Sehwani2/haptic-macropad/hw/PCB.jpeg

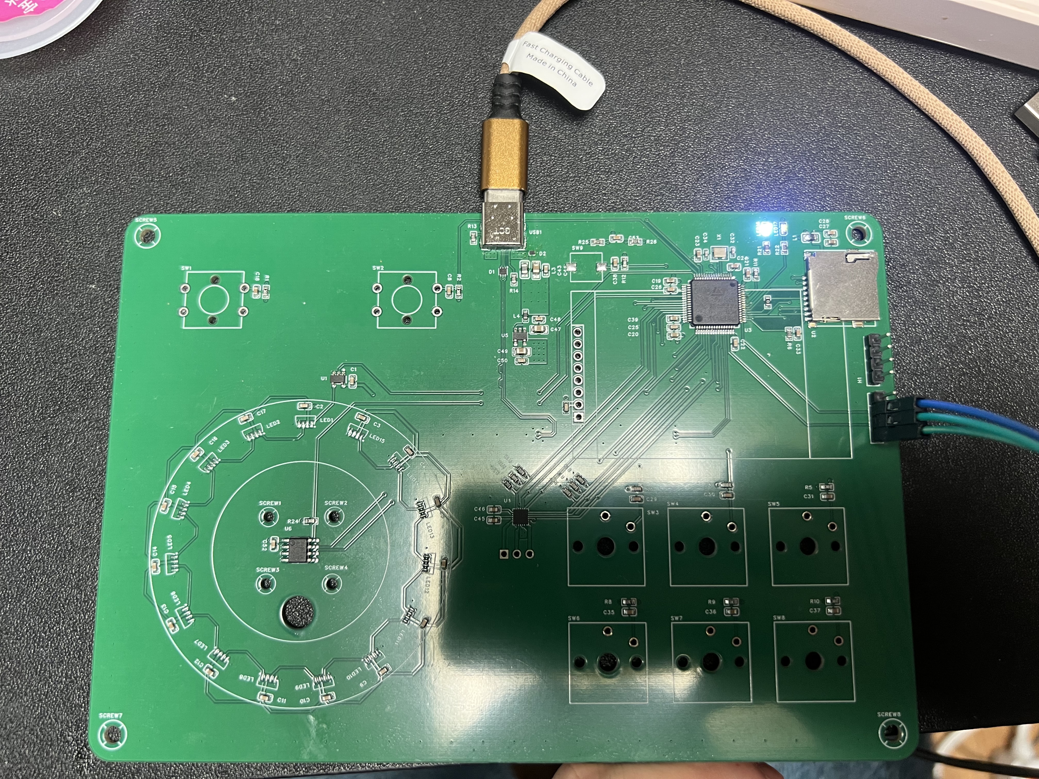
hw/PCB.jpeg
