Sehwani2/haptic-macropad/hw/layout.png

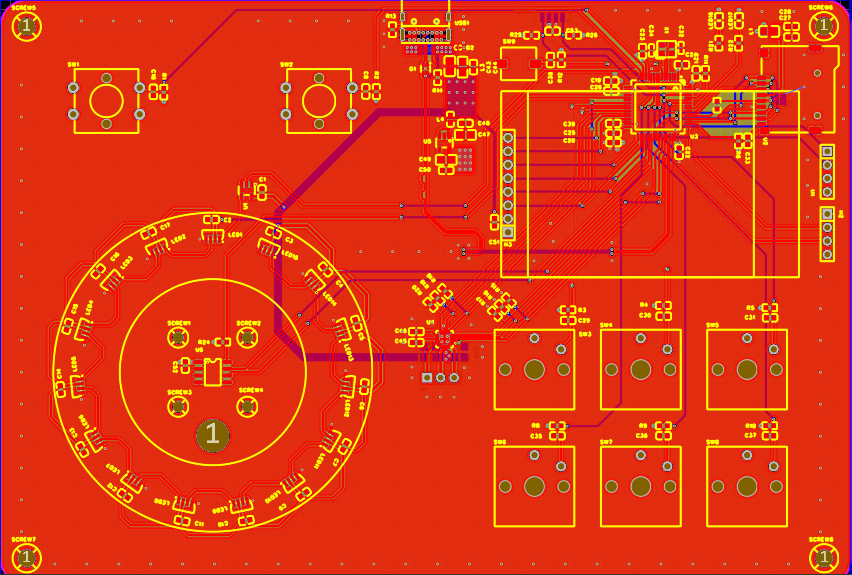
hw/layout.png
