Sehwani2/haptic-macropad/hw/schematic.png

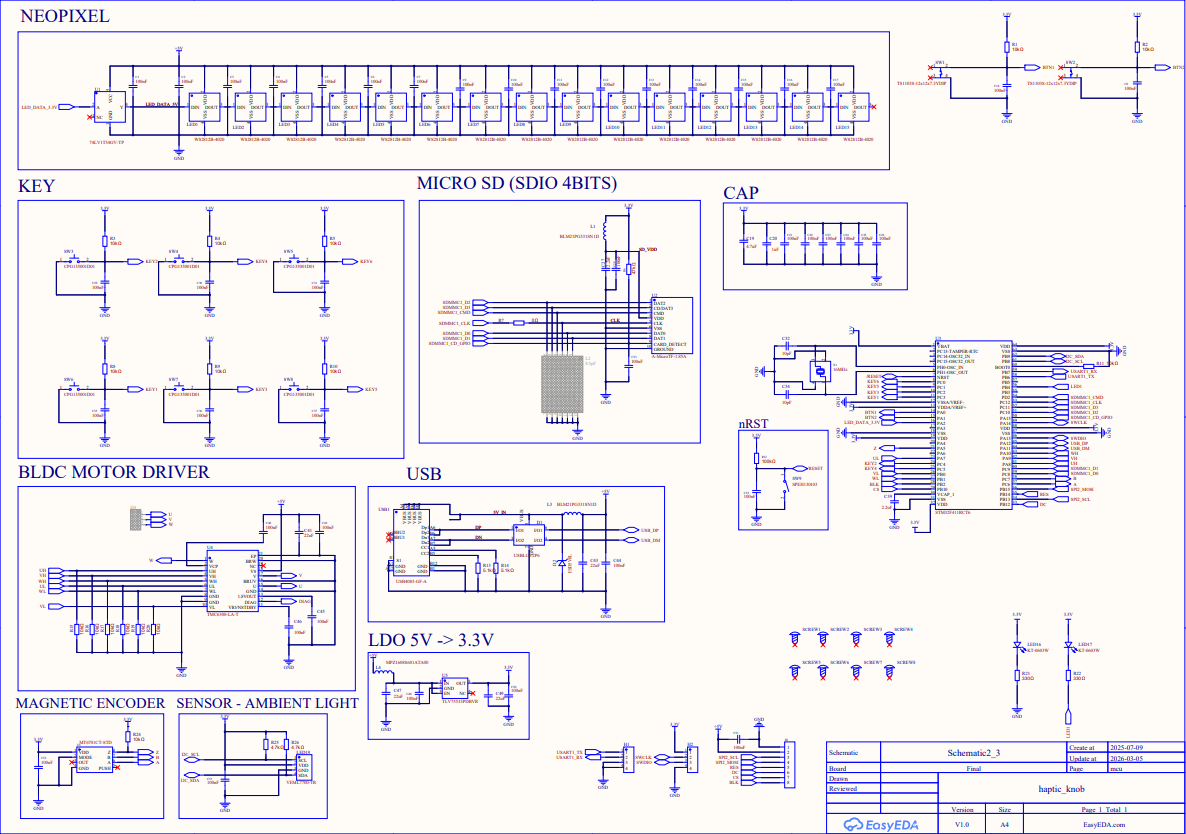
hw/schematic.png
