Sehwani2/haptic-macropad/(list of files, drawings)

Other design files:
hw/haptic_knob.eprj
