Sehwani2/haptic-macropad/fw/bldc_knob_key/bldc_knob_key.ioc

Mcu.UserName=STM32F411RCTx
PA0-WKUP.GPIO_Label=BTN1
PA0-WKUP.Signal=GPIO_Input
PA1.GPIO_Label=BTN2
PA1.Signal=GPIO_Input
PA10.Signal=S_TIM1_CH3
PA11.Signal=USB_OTG_FS_DM
PA12.Signal=USB_OTG_FS_DP
PA13.Signal=SYS_JTMS-SWDIO
PA14.Signal=SYS_JTCK-SWCLK
PA15.GPIO_Label=SDMMC1_CD_GPIO
PA15.Signal=GPIO_Input
PA2.Signal=S_TIM2_CH3
PA5.GPIO_Label=Z
PA5.Signal=GPXTI5
PA7.Signal=TIM1_CH1N
PA8.Signal=S_TIM1_CH1
PA9.Signal=S_TIM1_CH2
PB0.Signal=TIM1_CH2N
PB1.Signal=TIM1_CH3N
PB10.GPIO_Label=LCD_CS
PB10.Signal=GPIO_Output
PB12.GPIO_Label=LCD_DC
PB12.Signal=GPIO_Output
PB13.Signal=SPI2_SCK
PB14.GPIO_Label=LCD_RES
PB14.Signal=GPIO_Output
PB15.Signal=SPI2_MOSI
PB2.GPIO_Label=LCD_BLK
PB2.Signal=GPIO_Output
PB4.GPIO_Label=LED1
PB4.Signal=GPIO_Output
PB6.Signal=USART1_TX
PB7.Signal=USART1_RX
PB8.Signal=I2C1_SCL
PB9.Signal=I2C1_SDA
PC0.GPIO_Label=KEY3
PC0.Signal=GPIO_Input
PC1.GPIO_Label=KEY6
PC1.Signal=GPIO_Input
PC10.Signal=SDIO_D2
PC11.Signal=SDIO_D3
PC12.Signal=SDIO_CK
PC2.GPIO_Label=KEY5
PC2.Signal=GPIO_Input
PC3.GPIO_Label=KEY4
PC3.Signal=GPIO_Input
PC4.GPIO_Label=KEY1
PC4.Signal=GPIO_Input
PC5.GPIO_Label=KEY2
PC5.Signal=GPIO_Input
PC6.Signal=S_TIM3_CH1
PC7.Signal=S_TIM3_CH2
PC8.Signal=SDIO_D0
PC9.Signal=SDIO_D1
PD2.Signal=SDIO_CMD
