Sehwani2/haptic-macropad/fw/bldc_knob_key/Core/Inc/main.h

#define KEY3_Pin GPIO_PIN_0
#define KEY3_GPIO_Port GPIOC
#define KEY6_Pin GPIO_PIN_1
#define KEY6_GPIO_Port GPIOC
#define KEY5_Pin GPIO_PIN_2
#define KEY5_GPIO_Port GPIOC
#define KEY4_Pin GPIO_PIN_3
#define KEY4_GPIO_Port GPIOC
#define BTN1_Pin GPIO_PIN_0
#define BTN1_GPIO_Port GPIOA
#define BTN2_Pin GPIO_PIN_1
#define BTN2_GPIO_Port GPIOA
#define Z_Pin GPIO_PIN_5
#define Z_GPIO_Port GPIOA
#define Z_EXTI_IRQn EXTI9_5_IRQn
#define KEY1_Pin GPIO_PIN_4
#define KEY1_GPIO_Port GPIOC
#define KEY2_Pin GPIO_PIN_5
#define KEY2_GPIO_Port GPIOC
#define LCD_BLK_Pin GPIO_PIN_2
#define LCD_BLK_GPIO_Port GPIOB
#define LCD_CS_Pin GPIO_PIN_10
#define LCD_CS_GPIO_Port GPIOB
#define LCD_DC_Pin GPIO_PIN_12
#define LCD_DC_GPIO_Port GPIOB
#define LCD_RES_Pin GPIO_PIN_14
#define LCD_RES_GPIO_Port GPIOB
#define SDMMC1_CD_GPIO_Pin GPIO_PIN_15
#define SDMMC1_CD_GPIO_GPIO_Port GPIOA
#define LED1_Pin GPIO_PIN_4
#define LED1_GPIO_Port GPIOB
