Sehwani2/haptic-macropad/fw/bldc_knob_key/App/hw/src/st7789.c

#include "st7789.h"
#include "st7789_regs.h"
#include "gpio.h"
#include "cli.h"
#include "stm32f4xx_ll_spi.h"

#ifdef _USE_HW_ST7789

#define _PIN_DEF_BL     0
#define _PIN_DEF_DC     2
#define _PIN_DEF_CS     3
#define _PIN_DEF_RST    1


#define MADCTL_MY       0x80
#define MADCTL_MX       0x40
#define MADCTL_MV       0x20
#define MADCTL_ML       0x10
#define MADCTL_RGB      0x00
#define MADCTL_BGR      0x08
#define MADCTL_MH       0x04

#define FRAME_BUF_CNT   5


static void writecommand(uint8_t c);
static void writedata(uint8_t d);
static void st7789InitRegs(void);
static void st7789SetRotation(uint8_t m);
static bool st7789Reset(void);
static void st7789DoneISR(SPI_HandleTypeDef *hspi);


extern SPI_HandleTypeDef hspi2;

static volatile bool is_ready = true;

static bool is_init = false;
static uint32_t pre_time_req;
static uint32_t exe_time_req;

static const int32_t _width  = HW_ST7789_WIDTH;
static const int32_t _height = HW_ST7789_HEIGHT;
static const uint32_t colstart = 1;
static const uint32_t rowstart = 2;



#ifdef _USE_HW_CLI
static void cliCmd(cli_args_t *args);
#endif





bool st7789Init(void)
{
  bool ret = true;

  if (is_init)
    return true;

  ret = st7789Reset();

  is_init = ret;

  HAL_SPI_RegisterCallback(&hspi2, HAL_SPI_TX_COMPLETE_CB_ID, st7789DoneISR);

#ifdef _USE_HW_CLI
  cliAdd("st7789", cliCmd);
#endif

  return ret;
}

void st7789DoneISR(SPI_HandleTypeDef *hspi)
{
  gpioPinWrite(_PIN_DEF_CS, _DEF_HIGH);

  hspi2.Init.DataSize = SPI_DATASIZE_8BIT;
  LL_SPI_SetDataWidth(hspi2.Instance, LL_SPI_DATAWIDTH_8BIT);

  exe_time_req = millis()-pre_time_req;
  is_ready = true;
}

bool st7789IsReady(void)
{
  return is_ready;
}

void st7789GetInfo(st7789_info_t *p_info)
{
  p_info->req_time = exe_time_req;
}

bool st7789Reset(void)
{
  gpioPinWrite(_PIN_DEF_BL , _DEF_LOW);
  gpioPinWrite(_PIN_DEF_DC , _DEF_HIGH);
  gpioPinWrite(_PIN_DEF_CS , _DEF_HIGH);
  gpioPinWrite(_PIN_DEF_RST, _DEF_LOW);
  delay(10);
  gpioPinWrite(_PIN_DEF_RST, _DEF_HIGH);

  st7789InitRegs();

  st7789SetRotation(1);
  st7789FillRect(0, 0, _width, _height, black);
  return true;
}

uint16_t st7789GetWidth(void)
{
  return _width;
}

uint16_t st7789GetHeight(void)
{
  return _height;
}

void writecommand(uint8_t c)
{
  gpioPinWrite(_PIN_DEF_DC, _DEF_LOW);
  gpioPinWrite(_PIN_DEF_CS, _DEF_LOW);

  HAL_SPI_Transmit(&hspi2, &c, 1, 50);

  gpioPinWrite(_PIN_DEF_CS, _DEF_HIGH);
}

void writedata(uint8_t d)
{
  gpioPinWrite(_PIN_DEF_DC, _DEF_HIGH);
  gpioPinWrite(_PIN_DEF_CS, _DEF_LOW);

  HAL_SPI_Transmit(&hspi2, &d, 1, 50);

  gpioPinWrite(_PIN_DEF_CS, _DEF_HIGH);
}

void st7789InitRegs(void)
{
  writecommand(ST7789_SWRESET); //  1: Software reset, 0 args, w/delay
  delay(10);

  writecommand(ST7789_SLPOUT);  //  2: Out of sleep mode, 0 args, w/delay
  delay(10);

 // writecommand(ST7789_INVON);  // 13: Don't invert display, no args, no delay
  writecommand(ST7789_INVOFF);

  writecommand(ST7789_MADCTL);  // 14: Memory access control (directions), 1 arg:
  writedata(0x08);              //     row addr/col addr, bottom to top refresh

  writecommand(ST7789_COLMOD);  // 15: set color mode, 1 arg, no delay:
  writedata(0x05);              //     16-bit color


  writecommand(ST7789_CASET);   //  1: Column addr set, 4 args, no delay:
  writedata(0x00);
  writedata(0x00);              //     XSTART = 0
  writedata((uint8_t)((HW_ST7789_WIDTH-1)>>8));
  writedata((uint8_t)((HW_ST7789_WIDTH-1)>>0));    //     XEND =

  writecommand(ST7789_RASET);   //  2: Row addr set, 4 args, no delay:
  writedata(0x00);
  writedata(0x00);              //     XSTART = 0
  writedata((uint8_t)((HW_ST7789_HEIGHT-1)>>8));
  writedata((uint8_t)((HW_ST7789_HEIGHT-1)>>0));   //     XEND =


  writecommand(ST7789_NORON);   //  3: Normal display on, no args, w/delay
  delay(10);
  writecommand(ST7789_DISPON);  //  4: Main screen turn on, no args w/delay
  delay(10);
}

void st7789SetRotation(uint8_t mode)
{
  writecommand(ST7789_MADCTL);

  switch (mode)
  {
   case 0:
     writedata(MADCTL_MX | MADCTL_MY | MADCTL_RGB);
     break;

   case 1:
     writedata(MADCTL_MY | MADCTL_MV | MADCTL_RGB);
     break;

  case 2:
    writedata(MADCTL_RGB);
    break;

   case 3:
     writedata(MADCTL_MX | MADCTL_MV | MADCTL_RGB);
     break;
  }
}

void st7789SetWindow(int32_t x0, int32_t y0, int32_t x1, int32_t y1)
{
  writecommand(ST7789_CASET);   // Column addr set
  writedata((x0+colstart)>>8);
  writedata((x0+colstart)>>0);  // XSTART
  writedata((x1+colstart)>>8);
  writedata((x1+colstart)>>0);  // XEND

  writecommand(ST7789_RASET);   // Row addr set
  writedata((y0+rowstart)>>8);
  writedata((y0+rowstart)>>0);  // YSTART
  writedata((y1+rowstart)>>8);
  writedata((y1+rowstart)>>0);  // YEND

  writecommand(ST7789_RAMWR);   // write to RAM
}

void st7789FillRect(int32_t x, int32_t y, int32_t w, int32_t h, uint32_t color)
{
  uint16_t line_buf[w];

  // Clipping
  if ((x >= _width) || (y >= _height)) return;

  if (x < 0) { w += x; x = 0; }
  if (y < 0) { h += y; y = 0; }

  if ((x + w) > _width)  w = _width  - x;
  if ((y + h) > _height) h = _height - y;

  if ((w < 1) || (h < 1)) return;


  st7789SetWindow(x, y, x + w - 1, y + h - 1);

  hspi2.Init.DataSize = SPI_DATASIZE_16BIT;
  LL_SPI_SetDataWidth(hspi2.Instance, LL_SPI_DATAWIDTH_16BIT);

  gpioPinWrite(_PIN_DEF_DC, _DEF_HIGH);
  gpioPinWrite(_PIN_DEF_CS, _DEF_LOW);

  for (int i=0; i<w; i++)
  {
    line_buf[i] = color;
  }
  for (int i=0; i<h; i++)
  {
    HAL_SPI_Transmit(&hspi2, (const uint8_t *)line_buf, w, 10);
  }
  gpioPinWrite(_PIN_DEF_CS, _DEF_HIGH);

  hspi2.Init.DataSize = SPI_DATASIZE_8BIT;
  LL_SPI_SetDataWidth(hspi2.Instance, LL_SPI_DATAWIDTH_8BIT);
}

bool st7789SendBuffer(uint8_t *p_data, uint32_t length, uint32_t timeout_ms)
{
  is_ready = false;
  pre_time_req = millis();

  hspi2.Init.DataSize = SPI_DATASIZE_16BIT;
  LL_SPI_SetDataWidth(hspi2.Instance, LL_SPI_DATAWIDTH_16BIT);

  gpioPinWrite(_PIN_DEF_DC, _DEF_HIGH);
  gpioPinWrite(_PIN_DEF_CS, _DEF_LOW);


  HAL_SPI_Transmit_DMA(&hspi2, (const uint8_t *)p_data, length);

  return true;
}



#ifdef _USE_HW_CLI

void cliCmd(cli_args_t *args)
{
  bool ret = false;


  if (args->argc == 1 && args->isStr(0, "info"))
  {
    cliPrintf("Width  : %d\n", _width);
    cliPrintf("Heigth : %d\n", _height);
    ret = true;
  }

  if (args->argc == 1 && args->isStr(0, "test"))
  {
    uint32_t pre_time;
    uint32_t pre_time_draw;
    uint16_t color_tbl[3] = {red, green, blue};
    uint8_t color_index = 0;


    pre_time = millis();
    while(cliKeepLoop())
    {
      if (millis()-pre_time >= 500)
      {
        pre_time = millis();

        if (color_index == 0) cliPrintf("draw red\n");
        if (color_index == 1) cliPrintf("draw green\n");
        if (color_index == 2) cliPrintf("draw blue\n");

        pre_time_draw = millis();
        st7789FillRect(0, 0, _width, _height, color_tbl[color_index]);
        color_index = (color_index + 1)%3;

        cliPrintf("draw time : %d ms\n", millis()-pre_time_draw);
      }
      delay(1);
    }

    ret = true;
  }

  if (ret == false)
  {
    cliPrintf("st7789 info\n");
    cliPrintf("st7789 test\n");
  }
}

#endif
#endif
