Sehwani2/haptic-macropad/fw/bldc_knob_key/App/hw/src/uart.c

#include "uart.h"

#ifdef _USE_HW_UART
#include "qbuffer.h"
#include "cli.h"

#ifdef _USE_HW_CDC
#include "cdc.h"
#endif


#define UART_RX_BUF_LENGTH        1024



typedef struct
{
  bool is_open;
  uint32_t baud;

  uint8_t  rx_buf[UART_RX_BUF_LENGTH];
  qbuffer_t qbuffer;
  UART_HandleTypeDef *p_huart;
  DMA_HandleTypeDef  *p_hdma_rx;

  uint32_t rx_cnt;
  uint32_t tx_cnt;
} uart_tbl_t;

typedef struct
{
  const char         *p_msg;
  USART_TypeDef      *p_uart;
  UART_HandleTypeDef *p_huart;
  DMA_HandleTypeDef  *p_hdma_rx;
  DMA_HandleTypeDef  *p_hdma_tx;
  bool                is_rs485;
} uart_hw_t;




static bool is_init = false;

static uart_tbl_t uart_tbl[UART_MAX_CH];

extern UART_HandleTypeDef huart1;
extern DMA_HandleTypeDef hdma_usart1_rx;

static const uart_hw_t uart_hw_tbl[UART_MAX_CH] =
  {
    {"USART1 SWD   ", USART1, &huart1, &hdma_usart1_rx, NULL, false},
  };





bool uartInit(void)
{
  for (int i=0; i<UART_MAX_CH; i++)
  {
    uart_tbl[i].is_open = false;
    uart_tbl[i].baud = 57600;
    uart_tbl[i].rx_cnt = 0;
    uart_tbl[i].tx_cnt = 0;
  }

  is_init = true;

  return true;
}

bool uartDeInit(void)
{
  return true;
}

bool uartIsInit(void)
{
  return is_init;
}

bool uartOpen(uint8_t ch, uint32_t baud)
{
  bool ret = false;
  HAL_StatusTypeDef ret_hal;


  if (ch >= UART_MAX_CH) return false;

  if (uart_tbl[ch].is_open == true && uart_tbl[ch].baud == baud)
  {
    return true;
  }


  switch(ch)
  {
    case _DEF_UART1:
      uart_tbl[ch].baud      = baud;

      uart_tbl[ch].p_huart   = uart_hw_tbl[ch].p_huart;
      uart_tbl[ch].p_hdma_rx = uart_hw_tbl[ch].p_hdma_rx;
      uart_tbl[ch].p_huart->Instance = uart_hw_tbl[ch].p_uart;

      uart_tbl[ch].p_huart->Init.BaudRate       = baud;
      uart_tbl[ch].p_huart->Init.WordLength     = UART_WORDLENGTH_8B;
      uart_tbl[ch].p_huart->Init.StopBits       = UART_STOPBITS_1;
      uart_tbl[ch].p_huart->Init.Parity         = UART_PARITY_NONE;
      uart_tbl[ch].p_huart->Init.Mode           = UART_MODE_TX_RX;
      uart_tbl[ch].p_huart->Init.HwFlowCtl      = UART_HWCONTROL_NONE;
      uart_tbl[ch].p_huart->Init.OverSampling   = UART_OVERSAMPLING_16;

      qbufferCreate(&uart_tbl[ch].qbuffer, &uart_tbl[ch].rx_buf[0], UART_RX_BUF_LENGTH);


      __HAL_RCC_DMA1_CLK_ENABLE();

      // HAL_UART_DeInit(uart_tbl[ch].p_huart);
      ret_hal = HAL_UART_Init(uart_tbl[ch].p_huart);

      if (ret_hal == HAL_OK)
      {
        ret = true;
        uart_tbl[ch].is_open = true;

        if(HAL_UART_Receive_DMA(uart_tbl[ch].p_huart, (uint8_t *)&uart_tbl[ch].rx_buf[0], UART_RX_BUF_LENGTH) != HAL_OK)
        {
          ret = false;
        }

        uart_tbl[ch].qbuffer.in  = uart_tbl[ch].qbuffer.len - ((DMA_Stream_TypeDef *)uart_tbl[ch].p_huart->hdmarx->Instance)->NDTR;
        uart_tbl[ch].qbuffer.out = uart_tbl[ch].qbuffer.in;
      }
      break;

    case _DEF_UART2:
      uart_tbl[ch].baud    = baud;
      uart_tbl[ch].is_open = true;
      ret = true;
      break;
  }

  return ret;
}

bool uartClose(uint8_t ch)
{
  if (ch >= UART_MAX_CH) return false;

  uart_tbl[ch].is_open = false;

  return true;
}

uint32_t uartAvailable(uint8_t ch)
{
  uint32_t ret = 0;


  switch(ch)
  {
    case _DEF_UART1:
      uart_tbl[ch].qbuffer.in = (uart_tbl[ch].qbuffer.len - ((DMA_Stream_TypeDef *)uart_tbl[ch].p_hdma_rx->Instance)->NDTR);
      ret = qbufferAvailable(&uart_tbl[ch].qbuffer);
      break;
  }

  return ret;
}

bool uartFlush(uint8_t ch)
{
  uint32_t pre_time;


  pre_time = millis();
  while(uartAvailable(ch))
  {
    if (millis()-pre_time >= 10)
    {
      break;
    }
    uartRead(ch);
  }

  return true;
}

uint8_t uartRead(uint8_t ch)
{
  uint8_t ret = 0;


  switch(ch)
  {
    case _DEF_UART1:
      qbufferRead(&uart_tbl[ch].qbuffer, &ret, 1);
      break;

    case _DEF_UART2:
      #ifdef _USE_HW_CDC
      ret = cdcRead();
      #endif
      break;
  }
  uart_tbl[ch].rx_cnt++;

  return ret;
}

uint32_t uartWrite(uint8_t ch, uint8_t *p_data, uint32_t length)
{
  uint32_t ret = 0;


  switch(ch)
  {
    case _DEF_UART1:
      if (HAL_UART_Transmit(uart_tbl[ch].p_huart, p_data, length, 100) == HAL_OK)
      {
        ret = length;
      }
      break;

    case _DEF_UART2:
      #ifdef _USE_HW_CDC
      ret = cdcWrite(p_data, length);
      #endif
      break;
  }
  uart_tbl[ch].tx_cnt += ret;

  return ret;
}

uint32_t uartPrintf(uint8_t ch, const char *fmt, ...)
{
  char buf[256];
  va_list args;
  int len;
  uint32_t ret;

  va_start(args, fmt);
  len = vsnprintf(buf, 256, fmt, args);

  ret = uartWrite(ch, (uint8_t *)buf, len);

  va_end(args);


  return ret;
}

uint32_t uartGetBaud(uint8_t ch)
{
  uint32_t ret = 0;


  if (ch >= UART_MAX_CH) return 0;

  ret = uart_tbl[ch].baud;

  return ret;
}

uint32_t uartGetRxCnt(uint8_t ch)
{
  if (ch >= UART_MAX_CH) return 0;

  return uart_tbl[ch].rx_cnt;
}

uint32_t uartGetTxCnt(uint8_t ch)
{
  if (ch >= UART_MAX_CH) return 0;

  return uart_tbl[ch].tx_cnt;
}


#endif
