Sehwani2/haptic-macropad/fw/bldc_knob_key/App/hw/src/gpio.c

#include "gpio.h"

#ifdef _USE_HW_GPIO

#include "cli.h"




typedef struct
{
  GPIO_TypeDef *port;
  uint32_t      pin;
  GPIO_PinState on_state;
  GPIO_PinState off_state;
  bool          init_value;
} gpio_tbl_t;


const gpio_tbl_t gpio_tbl[GPIO_MAX_CH] =
    {
        {LCD_BLK_GPIO_Port, LCD_BLK_Pin, GPIO_PIN_SET,   GPIO_PIN_RESET, _DEF_LOW},   // 0. LCD BLK
        {LCD_RES_GPIO_Port, LCD_RES_Pin,  GPIO_PIN_SET,   GPIO_PIN_RESET, _DEF_HIGH},  // 1. LCD RES
        {LCD_DC_GPIO_Port , LCD_DC_Pin,  GPIO_PIN_SET,   GPIO_PIN_RESET, _DEF_LOW},   // 2. LCD DC
        {LCD_CS_GPIO_Port , LCD_CS_Pin,  GPIO_PIN_SET,   GPIO_PIN_RESET, _DEF_HIGH},  // 3. LCD CS
    };


#ifdef _USE_HW_CLI
static void cliGpio(cli_args_t *args);
#endif





bool gpioInit(void)
{
  bool ret = true;



  for (int i=0; i<GPIO_MAX_CH; i++)
  {
    gpioPinWrite(i, gpio_tbl[i].init_value);
  }

#ifdef _USE_HW_CLI
  cliAdd("gpio", cliGpio);
#endif
  return ret;
}

bool gpioPinMode(uint8_t ch, uint8_t mode)
{
  bool ret = true;
  return ret;
}

void gpioPinWrite(uint8_t ch, uint8_t value)
{
  if (ch >= GPIO_MAX_CH)
  {
    return;
  }

  if (value)
  {
    HAL_GPIO_WritePin(gpio_tbl[ch].port, gpio_tbl[ch].pin, gpio_tbl[ch].on_state);
  }
  else
  {
    HAL_GPIO_WritePin(gpio_tbl[ch].port, gpio_tbl[ch].pin, gpio_tbl[ch].off_state);
  }
}

uint8_t gpioPinRead(uint8_t ch)
{
  bool ret = false;

  if (ch >= GPIO_MAX_CH)
  {
    return false;
  }

  if (HAL_GPIO_ReadPin(gpio_tbl[ch].port, gpio_tbl[ch].pin) == gpio_tbl[ch].on_state)
  {
    ret = true;
  }

  return ret;
}

void gpioPinToggle(uint8_t ch)
{
  if (ch >= GPIO_MAX_CH)
  {
    return;
  }

  HAL_GPIO_TogglePin(gpio_tbl[ch].port, gpio_tbl[ch].pin);
}

void cliGpio(cli_args_t *args)
{
  bool ret = false;


  if (args->argc == 1 && args->isStr(0, "show") == true)
  {
    while(cliKeepLoop())
    {
      for (int i=0; i<GPIO_MAX_CH; i++)
      {
        cliPrintf("%d", gpioPinRead(i));
      }
      cliPrintf("\n");
      delay(100);
    }
    ret = true;
  }

  if (args->argc == 2 && args->isStr(0, "read") == true)
  {
    uint8_t ch;

    ch = (uint8_t)args->getData(1);

    while(cliKeepLoop())
    {
      cliPrintf("gpio read %d : %d\n", ch, gpioPinRead(ch));
      delay(100);
    }

    ret = true;
  }

  if (args->argc == 3 && args->isStr(0, "write") == true)
  {
    uint8_t ch;
    uint8_t data;

    ch   = (uint8_t)args->getData(1);
    data = (uint8_t)args->getData(2);

    gpioPinWrite(ch, data);

    cliPrintf("gpio write %d : %d\n", ch, data);
    ret = true;
  }

  if (ret != true)
  {
    cliPrintf("gpio show\n");
    cliPrintf("gpio read ch[0~%d]\n", GPIO_MAX_CH-1);
    cliPrintf("gpio write ch[0~%d] 0:1\n", GPIO_MAX_CH-1);
  }
}

#endif
