Sehwani2/haptic-macropad/(commit log)

2026-05-15 Initial commit: STM32 haptic macro pad project
2026-06-13 모터 정렬 문제 해결
