Sehwani2/haptic-macropad/(notices)

Notices in the files:
fw/bldc_knob_key/Core/Inc/main.h:
Copyright (c) 2026 STMicroelectronics.
All rights reserved.
This software is licensed under terms that can be found in the LICENSE file
